luyou-2023/VCU-DEV-DOCS/VCU整套开发源码+PCB原理图+说明书/VCU用户资料/软件部分/基于J1939整车控制器CAN协议说明文档.pdf

整车控制器通讯协议 版本： | V0.1.0 | 2014/10/5
本协议参照SAEJ1939标准 | 整车网络通讯硬件要求
CAN总线结点地址如果J1939已有定义，则尽量使用J1939已定义的地址；1）各系统相互间的数据交换必须通过整车控制器才能实现；
具有多个功能的VCU，可以使用多个地址也可以重新定义新的地址； 2）网络系统支持热拔插，电源应具有反接保护和掉电检测功能；
新定义地址，应使用208～231这段属于公路用车的预留地址， | 3）控制器电源应符合GB/T11858.3标准的规定
报文编号为分配给每个结点的能进行目的寻址的报文编号空间。 | 4）CAN总线的通信电缆采用屏蔽双绞线（阻燃0.5mm），屏蔽层应连接到CAN_GND，屏蔽线的接地方式由整车布线时选择合适位置单点接地；
整车控制器 | SA=39 | SAEJ1939已定义 | 5）网络的接线拓扑为一个尽量紧凑的线形结构以避免电缆反射。
电机控制器 | SA=239 | SAEJ1939已定义 | VCU接入总线主干网的电缆要尽可能短。为使驻波最小化，节点不能在网络上等间距接入，接入线也不能等长，且接入线的最大长度应小于1m；
电池管理系统 SA=243 | SAEJ1939已定义 | 6）CAN总线上各部件均有终端电阻（120Ω ），同时，终端电阻同网络线之间通过跳线连接，以便灵活搭配，方便调试使用，装车时去掉；
DC/DC | SA=214 | 新定义 | 7）终端电阻头(120Ω )安装在网络线两端，做在线束中；
充电机 | SA=229 | 新定义 | 8）所有通信电缆应尽量离开动力线（0.5m以上）、离开12V控制线（0.1m以上）；
数字仪表 | SA=40 | SAEJ1939已定义 | 9）电缆屏蔽层在车内连续导通，建议每个部件的网络插座有屏蔽层的接头；
空调 | SA=231 | 新定义 | 10）CAN总线所有结点均有光耦隔离。

CAN 总 线 网
络报文结构图 | 发送节点 | 接收节点 | 波特率

### 以上为29标 识符的分配

表：

其中，优先级为3位，可以有8个优先级；R一般固定为0；DP现固定为0； | 字节 | 位 | 分辨率
8位的PF为报文的代码； | 0
8位的PS为目标地址或组扩展；8位的SA为发送此报文的源地址。 | 1

3
4 | ChargeConnect | 充电线连接 | 0：未连接1：已连接
5 | ChargeState | 电池组充电 | 0：未充电1：正在充电
6 | VechileMode | 整车模式 | 0：动力模式1：经济模式
7
1 | | AccPedalPos | 加速踏板位置 | 0~100%（0-1000） 偏移量：0 | 0.1%/bit

2

3 | | BrakePedalPos | 制动踏板位置 | 0~100%（0-1000） | 0.1%/bit
4
5 | 0 | VCUState | 整车控制器Ready | 0：ready 1：no ready
| 1 | BMSState | 电池管理单元在线 | 00：自检成功 01，10进行中
2
3 | DriveSysState | 驱动系统在线 | 0：正常1：故障
4 | AccPedalState | 加速踏板故障 | 0：正常1：故障
5 | BrakePedalState | 制动踏板故障 | 0：正常1：故障
6 | DCDCState | DCDC故障 | 0：正常1：故障
7 | ACState | 空调故障 | 0：正常1：故障
6 0.2V/bit | | LowBatVoltage | 低压电池电压 | 0-50V 偏移量：0
7
报文名称 | 发送节点 | 接收节点 | ID(hex) | 波特率
报文2 formVCU to Display | VCU | DISPLAY | 0X0C012827 | 250kb/s
P | R | DP | PF | PS | SA | 发送周期
3 | 0 | 0 | 1 | 40 | 39 | 100ms
字节 | 位 | 信号名称 | 物理含义 | 范围与含义 | 分辨率
0 | | MotorSpeed | 电机转速 | 0~16063.75rpm（0~64255） | 0.25rpm/bit
1
| 0 | MCUOverVol | MCU过压报警 | 0：正常1：报警
| 1 | MCULowVol | MCU欠压报警 | 0：正常1：报警
| 2 | MCUOverCurr | MCU过流报警 | 0：正常1：报警
| 3 | MCUOverTem 2 | MCU温度保护报警 | 0：正常1：报警
| 4 | MCUDriveFault | MCU驱动保护 | 0：正常1：报警
| 5 | MotorOverTemp | 电机过温 | 0：正常1：报警
| 6 | MotorState | 电机状态 | 0：正常1：报警
| 7
3 0.1℃/bit | | MCUTemp | 电机控制器温度 | -40~210℃偏移量40
4 0.1℃/bit | | MotorTemp | 电机温度 | -40~210℃ 偏移量40
5 | 0 | MCUWorkeState | MCU工作状态 | 1：工作 0：停止工作
| 1 | MotorWorkeMode | 电机工作模式 | 1：转矩模式0：转速模式
| 2 | MotorDirection | 电机运行方向 | 1：电机正转0：电机反转
| 3 | MotorLoad | 电机降功率运行 | 0：正常 1 ：降功率
| 4
| 5
| 6
| 7
6 1(km/h)/bit | | VehicleSpeed | 车速 | 0~200 偏移量0
7 | | | 电机控制器时序标号 | 0～255 循环
报文名称 | 发送节点 | 接收节点 | ID(hex) | 波特率
报文4 formVCU to Display | VCU | DISPLAY | 0X18032827 | 250kb/s
P | R | DP | PF | PS | SA | 发送周期
6 | 0 | 0 | 3 | 40 | 39 | 100ms
字节 | 位 | 信号名称 | 物理含义 | 范围与含义 | 分辨率
0 | | BatteryVoltage | 电池总电压 | 0~1000 偏移量：0 | 0.1V/bit
1
2 | | BatteryCurrent | 电池总电流 | -3200~3200偏移量3200 | 0.1A/bit
3
4 0.4%V/bit | | BatterySOC | 电池SOC | 0~100%
5 | 0 | ModuVolHigh 模块电压过高（停止充电） | | 0：正常1：报警
| 1 | ModuVolLow | 模块电压过低 | 0：正常1：报警
| 2 | SOCHigh | SOC过高（停止充电） | 0：正常1：报警
| 3 | SOCLow | SOC过低（需补电） | 0：正常1：报警
| 4 | CurrentHigh | 过电流 | 0：正常1：报警
| 5 | OverTemp | 温度过高停车 | 0：正常1：报警
| 6 | UnderSOC | SOC太低停车 | 0：正常1：报警
| 7 | NoMatch | 不匹配 | 0：正常1：报警
6 | 0 | BatBalancFault | 电池均衡故障 | 0：正常1：报警
| 1 | InsulatFault | 绝缘等级 | 00：无故障 01：1级故障 10：2级故障11：备用
2
3 | Connect1stFault | 第1箱连接故障 | 0：正常1：报警
4 | Connect2ndFault | 第2箱连接故障 | 0：正常1：报警
5 | Connect3rdFault | 第3箱连接故障 | 0：正常1：报警
6 | Connect4thFault | 第4箱连接故障 | 0：正常1：报警
7 | Connect5veFault | 第5箱连接故障 | 0：正常1：报警
7 | 0 | Connect6thFault | 第6箱连接故障 | 0：正常1：报警
| 1 | Connect7enFault | 第7箱连接故障 | 0：正常1：报警
| 2 | Connect8htFault | 第8箱连接故障 | 0：正常1：报警
| 3—7 | reserved | …
报文名称 | | | ID(hex)
报文1 formVCU to Display | VCU | DISPLAY | 0x0C002827 | 250kb/s
P | R | DP | PF | PS | SA | 发送周期
3 | 0 | 0 | 0 | 40 | 39 | 100ms
| | 信号名称 | 物理含义 | 范围与含义
0 | | GearPosition | 档位位置 | 00：空挡 01：倒档 10：前进 11：备份
| 2 | KEYSwitch | 点火钥匙位置信息 | 00：OFF 01：ACC 10：ON 11：STAR

报文名称 | 发送节点 | 接收节点 | ID(hex) | 波特率
报文4 formVCU to Display | VCU | DISPLAY | ID=0X18042827 | 250kb/s
P | R | DP | PF | PS | SA | 发送周期
6 | 0 | 0 | 4 | 40 | 39 | 100ms
字节 | 位 | 信号名称 | 物理含义 | 范围与含义 | 分辨率
0 | | BatteryMinVol | 电池模块最低电压 | 0~15 偏移量：0 | 0.01V/bit
1
2 | | BatteryMaxVol | 电池模块最高电压 | 偏移量：0 | 0.01A/bit 0~15
3
4 0.1℃/bit | | BatteryMaxTemp | 电池模块最高温度 | -40~210℃ 偏移量40
5 0.1℃/bit | | BatteryTempDiff | 电池模块最低温度 | -40~210℃ 偏移量40
6 2Ah/bit | | RestSoc | 剩余容量 | 0~510Ah偏移量：0
7 | | BatteryLife | 电池管理系统时序标号 | 0～255 循环
报文名称 | 发送节点 | 接收节点 | ID(hex) | 波特率
| DISPLAY | VCU | ID=0X18472728 | 250kb/s
P | R | DP | PF | PS | SA | 发送周期
6 | 0 | 0 | 71 | 39 | 40 | 100ms
字节 | 位 | 信号名称 | 物理含义 | 范围与含义 | 分辨率
0 | 0
| 1
| 2
| 3 | BrakePedalIO | 刹车开关 | 0：关1：开
| 4 | HandBrakeSwitch | 仪表单元工作状态 | 0：不正常1：正常
| 5 | DisplayState | 手刹制动开关 | 0：关1：开
| 6
| 7
1 | | TotalMileage | 里程 | 0~30万公里，偏移量：0 | 0.1(km/h)/bit
2
3
4
5 0.2V/bit, | | LowBatteryVol | 低压电池电压 | 0-50,偏移量：0
6 | | LIFE | 时序标号 | 0～255 循环
7
报文名称 | 发送节点 | 接收节点 | ID(hex) | 波特率
报文1 formVCUtoAC | VCU | AC | 0X183BE727 | 250kb/s
P | R | DP | PF | PS | SA | 发送周期
6 | 0 | 0 | 59 | 231 | 39 | 200ms
字节 | 位 | 信号名称 | 物理含义 | 范围与含义 | 分辨率
0 0.4%V/bit | | BatterySOC | 电池SOC | 0~100%
1 1℃/bit | | SetLowTemp | 制冷空调最低温度设定 | -40~210℃ 偏移量40
2 1℃/bit | | SetHighTemp | 制冷空调最高温度设定 | -40~210℃ 偏移量40
3 | | LIFE | 时序标号 | 0～255 循环
4
5
6
7
报文名称 | 发送节点 | 接收节点 | ID(hex) | 波特率
报文1 formACtoVCU | AC | VCU | 0X184C27E7 | 250kb/s
P | R | DP | PF | PS | SA | 发送周期
6 | 0 | 0 | 76 | 39 | 231 | 200ms
字节 | 位 | 信号名称 | 物理含义 | 范围与含义 | 分辨率
0 1℃/bit | | InterTemp | 室内温度 | -40~210℃ 偏移量40
1 0.4%V/bit | | ACLoad | 空调负荷 | 0~100%
| 0 | PressFault | 压力异常 | 00：正常01：过高 10：过低11：备份
1
2 | VoltagFault | 过欠压报警 | 0：正常1：过欠压
3 | OverCurrent | 过流 | 0：正常1：过流 2
4
5
6
7
3
4 | | LIFE | 时序标号 | 0～255 循环
5
6
7

报文1
formDisplay toVCU

报文名称 | 发送节点 | 接收节点 | ID(hex) | 波特率
报文1 formVCUtoCDDC | VCU | DCDC | ID=0X183BD627 | 250kb/s
P | R | DP | PF | PS | SA | 发送周期
6 | 0 | 0 | 59 | 214 | 39 | 200ms
字节 | 位 | 信号名称 | 物理含义 | 范围与含义 | 分辨率
0 | | DCDCNum | DCDC编号 | 0~1111
1 | 0
| 1
| 2
| 3
| 4
| 5 | DCDCCurDir | 控制DC/DC电流方向 | 0：正向1：反向
| 6 | DCDCSwitch | 控制DC/DC开关 | 0：未接通1：已接通
| 7
2
3
4 1A/bit | | DCDCRefCur | DC/DC目标电流 | .-32000~32255偏移量：-
5 1V/bit | | DCDCRefVol | DC/DC目标电压 | 0~64255偏移量：1
6 | | LIFE | 时序标号 | 0～255 循环
7
报文名称 | 发送节点 | 接收节点 | ID(hex) | 波特率
报文2 formVCUtoMCU | VCU | MCU | ID=0x0C40EF27 | 500kb/s
P | R | DP | PF | PS | SA | 发送周期
3 | 0 | 0 | 64 | 239 | 39 | 10ms
字节 | 位 | 信号名称 | 物理含义 | 范围与含义 | 分辨率
0 | | MotorRefSpeed | 电机目标转速 | 0~15000,(0~15000) | 0.1RPM/位
1
2 | | MotorRefTorque | 电机目标转矩 | 0.1Nm/位, -1000~1000,(0~20000) | 0.1Nm/位
3
4 | 0 | MCUWorkeState | MCU工作状态 | 1：工作 0：停止工作
| 1 | MotorWorkeMode | 电机工作模式 | 1：转矩模式0：转速模式
| 2 | MotorDirection | 电机运行方向 | 1：电机正转0：电机反转
| 3 | MotorLoad | 电机降功率运行 | 0：正常 1 ：降功率
| 4
| 5
| 6
| 7
5 | | LIFE | 整车控制器时序标号 | 0～255 循环
6 | | MaxSpeed | 电机最大转速 电机目标转速,,0~15000,(0~15000) | | 0.1RPM/位
7
报文名称 | 发送节点 | 接收节点 | ID(hex) | 波特率
报文1 formVCUtoMCU | VCU | MCU | ID=0x1811EF27 | 500kb/s
P | R | DP | PF | PS | SA | 发送周期
6 | 0 | 0 | 17 | 239 | 39 | 10ms
字节 | 位 | 信号名称 | 物理含义 | 范围与含义 | 分辨率
0 | | AccPedal | 加速踏板开度 | 0~100%（0-1000） 偏移量：0 | 0.1%/bit
1
2 | | BrakePedal | 制动踏板开度 | 0~100%（0-1000） | 0.1%/bit
3
4 | 0 | KEYSwitch | 点火钥匙位置信息 | 00：OFF 01：ACC 10：ON 11：STAR
1
2
3
4 | MCUStart | MC允许启动 | 0：不允许 1：允许
5 | MCUDischarge | 电容放电指令 | 00：不允许 01：允许
6
7
5
6
7
报文名称 | 发送节点 | 接收节点 | ID(hex) | 波特率
报文1 formMCUtoVCU | MCU | VCU | ID=0x0C2027EF | 500kb/s
P | R | DP | PF | PS | SA | 发送周期
3 | 0 | 0 | 32 | 39 | 239 | 10ms
字节 | 位 | 信号名称 | 物理含义 | 范围与含义 | 分辨率
0 | 0 | RelayStatus | 接触器状态 | 1：闭合 0：断开
| 1 | MotorEleGen | 电机工作模式 | 1：发电 0：电动
| 2 | MotorWorkState1 | 电机运行状态1 | 1：空转 0：其他
| 3 | MotorWorkState2 | 电机运行状态2 | 1：转矩模式0：转速模式
| 4 | MotorWorkState3 | 电机运行状态3 | 1：反转0：正转 1：冷却风开0：冷却风关
| 5 | FanState | 冷却风机状态
| 6
| 7 | MCUFault | 电动机控制器故障状 | 1：故障 0：正常
1 | | LIFE | LIFE | 0~255
2 | | MotorSpeed | 电动机转速 | 0~15000,t, 偏移量：0 | 0.1RPM/bi
3
4 | | MotorTorque | 电机扭矩 | ,-1000~1000,(0~20000) 偏移 量10000 | 0.01Nm/位
5
6 | | MotorCurrent | 电动机相电流 | 0~20000,偏移量：10000 | 0..1A/bit
7

GearPosition

档位 | 00：N 01：D 10：R 11：备用

报文名称 | 发送节点 | 接收节点 | ID(hex) | 波特率
报文2 formMCUtoVCU | MCU | VCU | ID=0x0C2127EF | 500kb/s
P | R | DP | PF | PS | SA | 发送周期
3 | 0 | 0 | 33 | 39 | 239 | 10ms
字节 | 位 | 信号名称 | 物理含义 | 范围与含义 | 分辨率
0 | | MCUTemp | 控制器温度 | .-40~210 偏移量：-40 | 0.1oC/bit
1
2 | | MotorTemp | 电动机温度 | .-40~210 偏移量：-40 | 0.1oC/bit
3
4 | | BatteryVoltage | 电池电压 | 0~10000，偏移量：0 | 0.1V/bit
5
6 | 0 | DCVoltaOver | 直流侧过压 | 1：过压0：正常
| 1 | IGBTFault | IGBT故障 | 1：故障0：正常
| 2 | OverCurrent | 过流 | 1：过流 0：正常
| 3 | BatteryOverVol | 电池过压 | 1：欠压 0：正常
| 4 | BatteryUnderVol | 电池过压 | 1：过压 0：正常
| 5 | MCUHot | 控制器过热 | 1：过热 0：正常
| 6 | MotorHot | 电池欠压 | 1：欠压 0：正常
| 7 | SpeedLimit | 超速 | 1：超速 0：正常
7 1(km/h)/bit | | VehicleSpeed | 车速 | 0~200 偏移量0
报文名称 | 发送节点 | 接收节点 | ID(hex) | 波特率
报文3 formMCUtoVCU | MCU | VCU | ID=0x0C2227EF | 500kb/s
P | R | DP | PF | PS | SA | 发送周期
3 | 0 | 0 | 34 | 39 | 239 | 10ms
字节 | 位 | 信号名称 | 物理含义 | 范围与含义 | 分辨率
0 | | MotorMaxDrivPow | 电机最大驱动功率 | 0~10000 偏移量：0 | 0.1kW/位
1
2 | | MotorMaxBrakPow | 电机最大制动功率 | 0~10000(0~1000) | 0.1kW/位
3
4 | | MotorMaxElecTrq | 电机最大电动转矩 | 0~10000(0~1000) | 0.1Nm/位
5
6 | | MotorMaxBrakTrq | 电机最大制动转 | 0~10000(0~1000) | 0.1Nm/位
7
报文名称 | 发送节点 | 接收节点 | ID(hex) | 波特率
报文1 formVCUtoBMS | VCU | BMS | ID=0x18FFF327 | 500kb/s
P | R | DP | PF | PS | SA | 发送周期
6 | 0 | 0 | 5534 | 243 | 39 | 10ms
字节 | 位 | 信号名称 | 物理含义 | 范围与含义 | 分辨率
0 1/bit | | LIFE | | 0~255，
1 | | AllowCharge | 充电运许 | 1 :允许 0：不允许
2
3 1(km/h) | | VehicleSpeed | 车速 | 0~200
4 | | TotalMileage | 里程 | 0~30万公里 偏移量：0 | 0.1(km/h)/bit
5
6
7
报文名称 | 发送节点 | 接收节点 | ID(hex) | 波特率
报文1 formBMStoVCU | BMS | VCU | ID=0x183027F3 | 500kb/s
P | R | DP | PF | PS | SA | 发送周期
6 | 0 | 0 | 48 | 39 | 243 | 10ms
字节 | 位 | 信号名称 | 物理含义 | 范围与含义 | 分辨率
0 | | BatteryVoltage | 电池总电压 | 0~1000，,偏移量：0 | 0.1V/bit
1
2 | | BatteryCurrent | 电池总电流 | .-3200~3353.5 偏移量：32000 | 0.1A/bit
3
4 0.4%V/bit | | BatterySOC | | 0~100，偏移量：0
5 1/bit | | LIFE | | 0~255，偏移量：0
6
7
报文名称 | 发送节点 | 接收节点 | ID(hex) | 波特率
报文2 formBMStoVCU | BMS | VCU | ID=0x183127F3 | 500kb/s
P | R | DP | PF | PS | SA | 发送周期
6 | 0 | 0 | 49 | 39 | 243 | 10ms
字节 | 位 | 信号名称 | 物理含义 | 范围与含义 | 分辨率
0 | 0 | BMSCheck | 电池管理系统自检状态 00：- 01：自检进行中 | 10自检成功 11自检失败
1
2 | ChargeConnect | 充电器连接 | 1：连接, 0：断开
3 | ChargeState | 充电状态 | 正在充电:1 充电完成：0
4
5
6
7
1 | 0 | ModuVolHigh | 模块电压高 | 1 :报警;0:未报警
| 1 | ModuVolLow | 模块电压低 | 1 :报警;0:未报警
| 2 | SOCHigh | SOC过高 | 1 :报警;0:未报警
| 3 | SOCLow | SOC过低需补电 | 1 :报警;0:未报警
| 4 | CurrentHigh | 过电流 | 1 :报警;0:未报警
| 5 | OverTemp | 温度过高 | 1 :报警;0:未报警
| 6 | UnderSOC | SOC太低 | 1 :报警;0:未报警
| 7 | NoMatch | 不匹配 | 1 :报警;0:未报警
2 | 0 | BatBalancFault | 电池均衡故障 | 0：正常,1：故障
| 1 | | 绝缘等级 InsulatFault | 00：无故障 01：1级故障 10：2级故障 11：备用
2
3 | Connect1stFault | 第1箱连接故障 | 0：正常,1：故障
4 | Connect2ndFault | 第2箱连接故障 | 0：正常,1：故障
5 | Connect3rdFault | 第3箱连接故障 | 0：正常,1：故障
6 | Connect4thFault | 第4箱连接故障 | 0：正常,1：故障
7 | Connect5veFault | 第5箱连接故障 | 0：正常,1：故障
3 | 0 | Connect6thFault | 第6箱连接故障 | 0：正常,1：故障
| 1 | Connect7enFault | 第7箱连接故障 | 0：正常,1：故障
| 2 | Connect8thFault | 第8箱连接故障 | 0：正常,1：故障
| 3
| 4
| 5
| 6
| 7
4 | | FaultNum | 故障数 | 0-256
5
6
7

报文名称 | 发送节点 | 接收节点 | ID(hex) | 波特率
报文3 formBMStoVCU | BMS | VCU | ID=0x183227F3 | 500kb/s
P | R | DP | PF | PS | SA | 发送周期
6 | 0 | 0 | 50 | 39 | 243 | 10ms
字节 | 位 | 信号名称 | 物理含义 | 范围与含义 | 分辨率
0 | 0 | VolHigh | 总电压高 | 1：故障,0：正常
| 1 | VolLow | 总电压低 | 1：故障,0：正常
| 2 | SingleVolHigh | 单体电压高 | 1：故障,0：正常
| 3 | SingleVolLow | 单体电压低, | 1：故障,0：正常
| 4 | SingleTempHigh | 单体温度高 | 1：故障,0：正常
| 5 | SingleTempLow | 单体温度低 | 1：故障,0：正常
| 6 | TempDiff | 温差大 | 1：故障,0：正常
| 7 | PressDiff | 压差大 | 1：故障,0：正常
1 | 0 | SOCLow | SOC低 | 1：故障,0：正常
| 1 | SOCHigh | SOC高 | 1：故障,0：正常
| 2
| 3
| 4
| 5
| 6
| 7
2 | 0 | PressDiffHigh | 压差过大 | 1：故障,0：正常
| 1 | TempDiffHigh | 温差过大 | 1：故障,0：正常
| 2 | STempServeLow | 单体温度过低 | 1：故障,0：正常
| 3 | STempServeHigh | 单体温度过高 | 1：故障,0：正常
| 4 | SVolServeLow | 单体电压过低 | 1：故障,0：正常
| 5 | SVolServeHigh | 单体电压过高 | 1：故障,0：正常
| 6 | VolServeLow | 总电压过低 | 1：故障,0：正常
| 7 | VolServeHigh | 总电压过高 | 1：故障,0：正常
3 | 0
| 1 | LowTempCharge | 低温充电告警 | 1：禁止充电,0：允许充电
| 2 | BMSFault | BMS系统故障 | 1：故障, 0：正常
| 3 | InsulatFult | 绝缘故障 | 1：故障, 0：正常
| 4 | DischargeCurrHi | 放电电流过大 | 1：故障, 0：正常
| 5 | ChargCurrHi | 充电电流过大 | 1：故障, 0：正常
| 6 | SOCServeHigh | SOC过高 | 1：故障, 0：正常
| 7 | SOCServeLow | SOC过低 | 1：故障, 0：正常
4
5
6
7 | | FaultNum | 故障数
报文名称 | 发送节点 | 接收节点 | ID(hex) | 波特率
报文4 formBMStoVCU | BMS | VCU | ID=0x183327F3 | 500kb/s
P | R | DP | PF | PS | SA | 发送周期
6 | 0 | 0 | 51 | 39 | 243 | 10ms
字节 | 位 | 信号名称 | 物理含义 | 范围与含义 | 分辨率
0 | | MaxChargeCur | 最大允许充电电流 | 0~10000，偏移量：0 | 0.1A/bit
1
2 | | MaxDisChargeCur | 最大允许放电电流 | 0~10000，偏移量：0 | 0.1A/bit
3
4 | | DischrgeVolCutOff | 放电截止电压 | 0~10000 偏移量：0 | 0.1V/bit
5
6
7
报文名称 | 发送节点 | 接收节点 | ID(hex) | 波特率
报文5 formBMStoVCU | BMS | VCU | ID=0x183427F3 | 500kb/s
P | R | DP | PF | PS | SA | 发送周期
6 | 0 | 0 | 52 | 39 | 243 | 10ms
字节 | 位 | 信号名称 | 物理含义 | 范围与含义 | 分辨率
0 | | BattAllowMaxTemp | 电池组最高允许温度。-40~210，偏移量：-40 | | 1oC/bit
1 0.4A/bit | | BattAllowLowSOC电池组允许放电最低SOC | | 0~250，偏移量：1
2 | | BatteryMinVol | 电池模块最低电压 | 0~15，偏移量：0 | 0.01V/bit
3
4 | | BatteryMaxVol | 电池模块最高电压 | 0~15，偏移量：0 | 0.01V/bit
5
6 1oC/bit | | BatteryMaxTemp | 电池模块最高温度 | 。-40~210偏移量：40
7 | | BatteryTempDiff | 电池模块温度极差 | 。-40~210偏移量：40 | 1oC/bit
