luyou-2023/VCU-DEV-DOCS/VCU整套开发源码+PCB原理图+说明书/VCU用户资料/软件部分/赠送资料/USBCAN接口卡/API/API Samples/vc6/test/说明.txt

exe程序 必须和 ControlCAN.dll 以及 kerneldlls 文件夹在一起
