luyou-2023/VCU-DEV-DOCS/VCU整套开发源码+PCB原理图+说明书/原理和PCB图/VCU原理图.pdf

# 晶电电电

# CAN通模

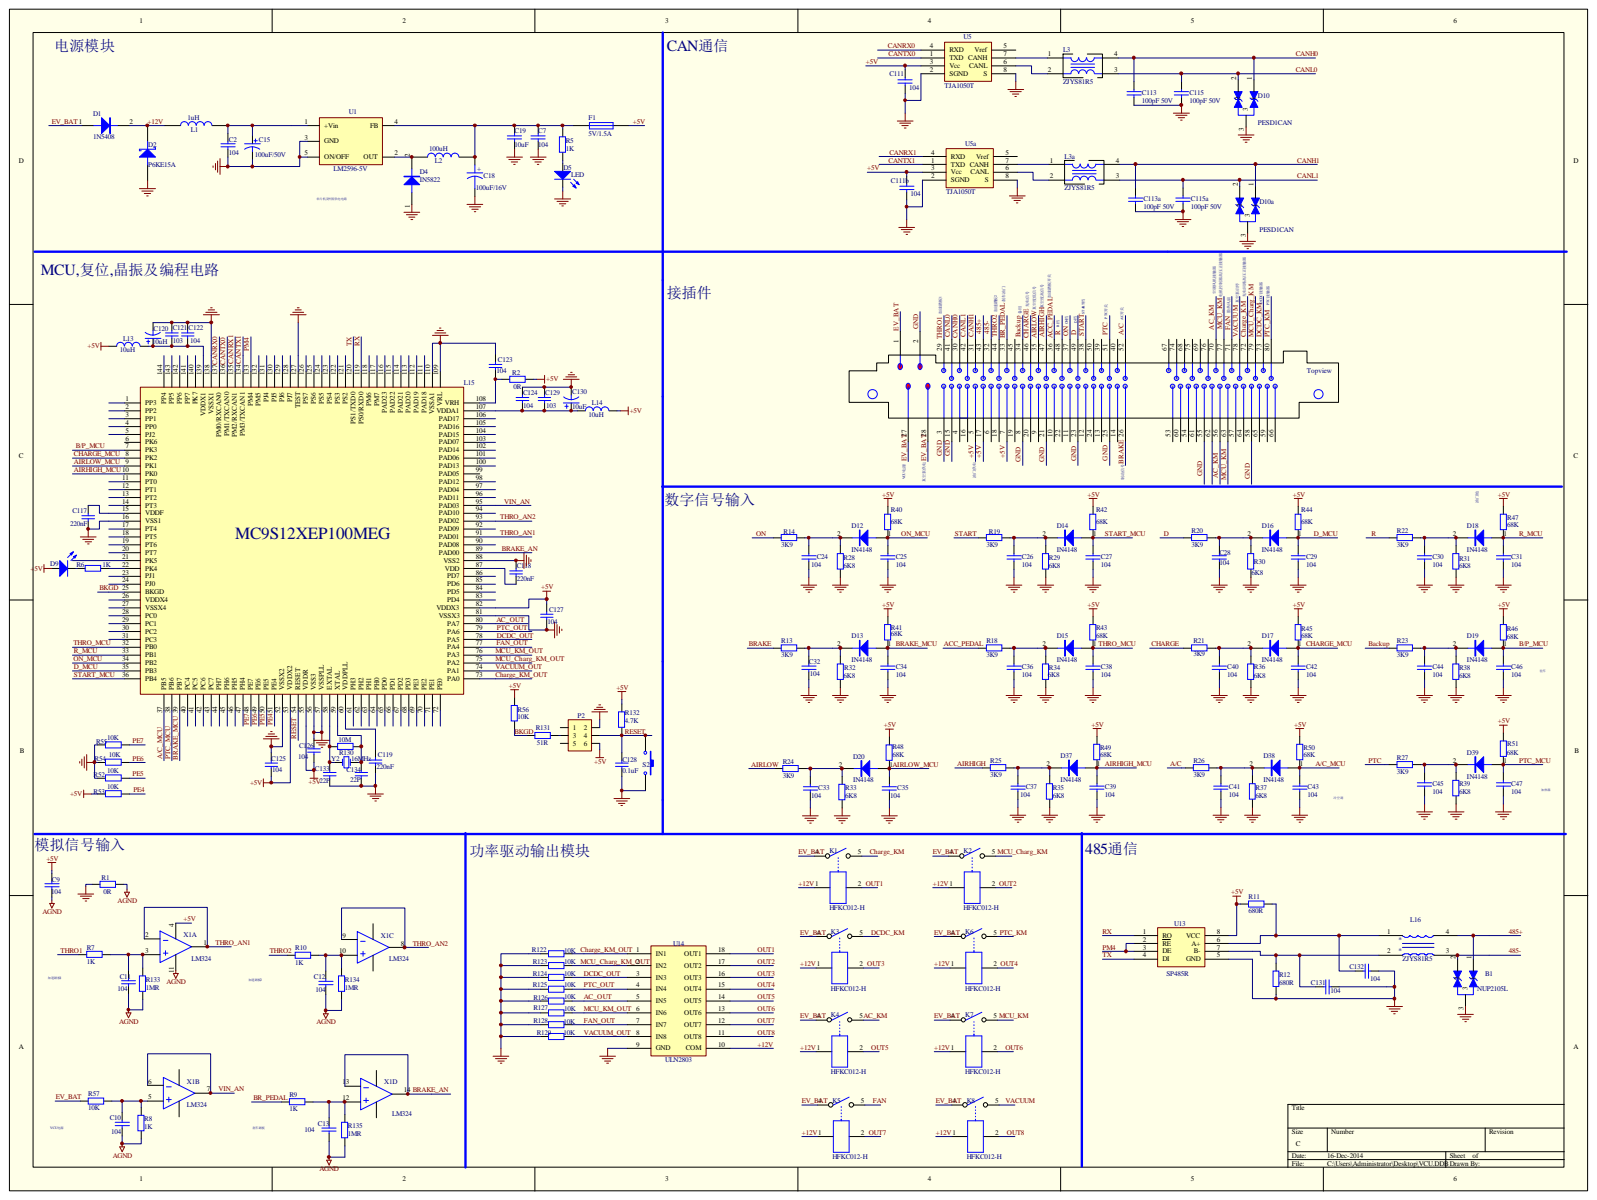
[picture p29: page 1]
