luyou-2023/VCU-DEV-DOCS/VCU整套开发源码+PCB原理图+说明书/VCU用户资料/软件部分/上位机使用说明文档.pdf

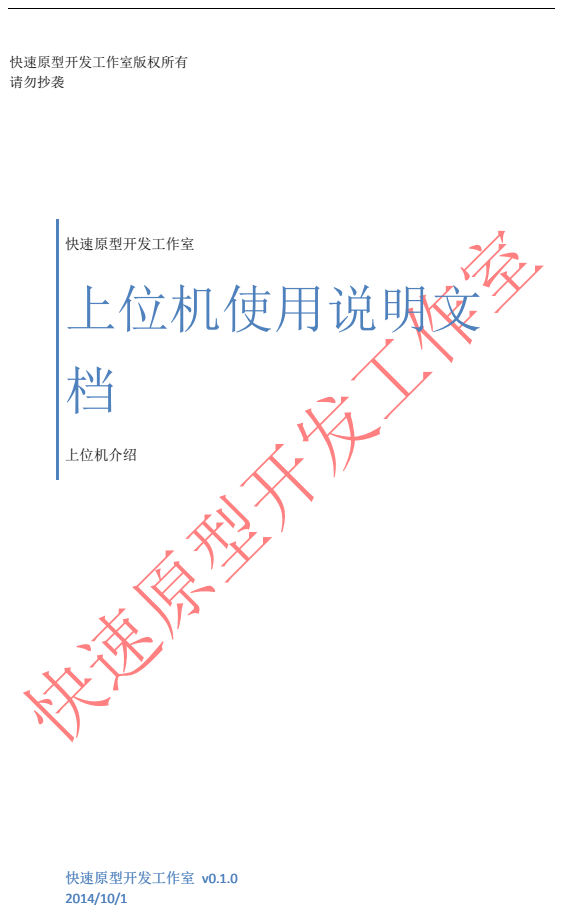
[picture p54: page 1]
快速原型开发工作室版权所有 请勿抄袭; 快速原型开发工作室 上位机使用说明文; 上位机介绍; 快速原型开发工作室 v0.1.0

# 1、上位机使用说明

## 上位机使用 485 总线实现参数的标定和数据的实时监控。上位机使用 labview

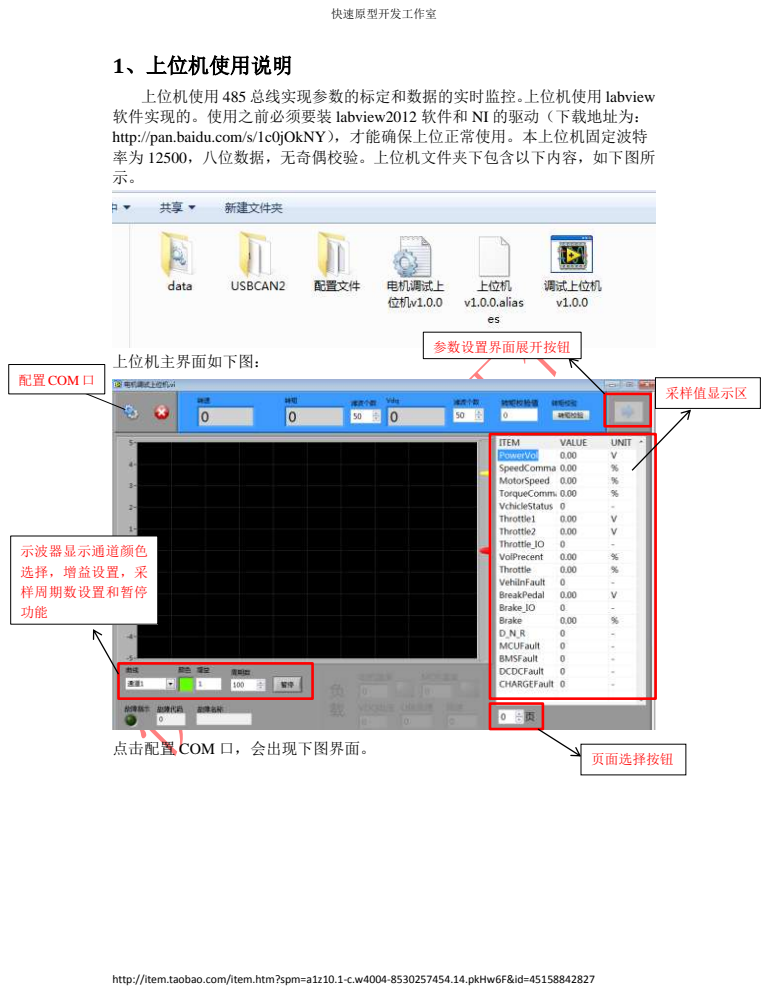
[picture p55: page 2]
快速原型开发工作室; 上位机主界面如下图：; 配置COM口; 采样值显示区; 页面选择按钮; 参数设置界面展开按钮; 示波器显示通道颜色 选择，增益设置，采 样周期数设置和暂停 功能

软件实现的。使用之前必须要装 labview2012 软件和 NI 的驱动（下载地址为：
http://pan.baidu.com/s/1c0jOkNY），才能确保上位正常使用。本上位机固定波特
率为 12500，八位数据，无奇偶校验。上位机文件夹下包含以下内容，如下图所

点击配置 COM 口，会出现下图界面。

http://item.taobao.com/item.htm?spm=a1z10.1-c.w4004-8530257454.14.pkHw6F&id=45158842827

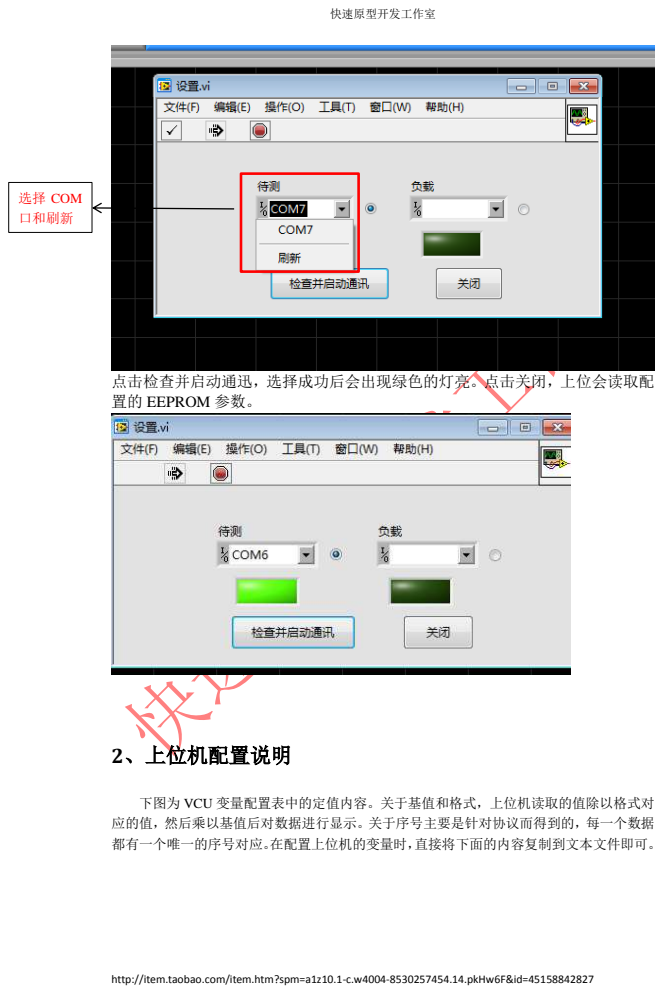
[picture p56: page 3]
2、上位机配置说明; 选择 COM 口和刷新

点击检查并启动通迅，选择成功后会出现绿色的灯亮。点击关闭，上位会读取配
置的 EEPROM 参数。

下图为 VCU 变量配置表中的定值内容。关于基值和格式，上位机读取的值除以格式对
应的值，然后乘以基值后对数据进行显示。关于序号主要是针对协议而得到的，每一个数据
都有一个唯一的序号对应。在配置上位机的变量时，直接将下面的内容复制到文本文件即可。

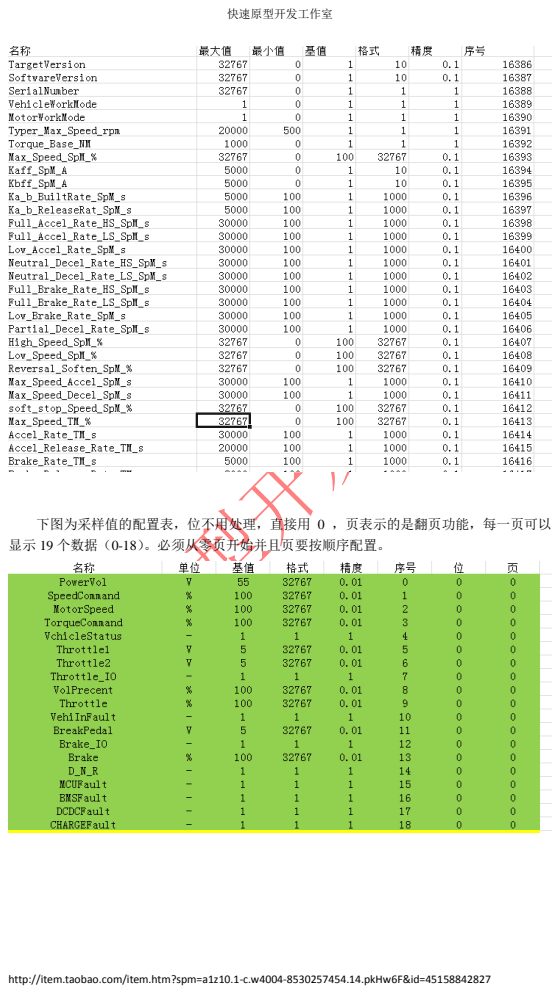
[picture p57: page 4]

下图为采样值的配置表，位不用处理，直接用 0 ，页表示的是翻页功能，每一页可以
显示 19 个数据（0-18）。必须从零页开始并且页要按顺序配置。

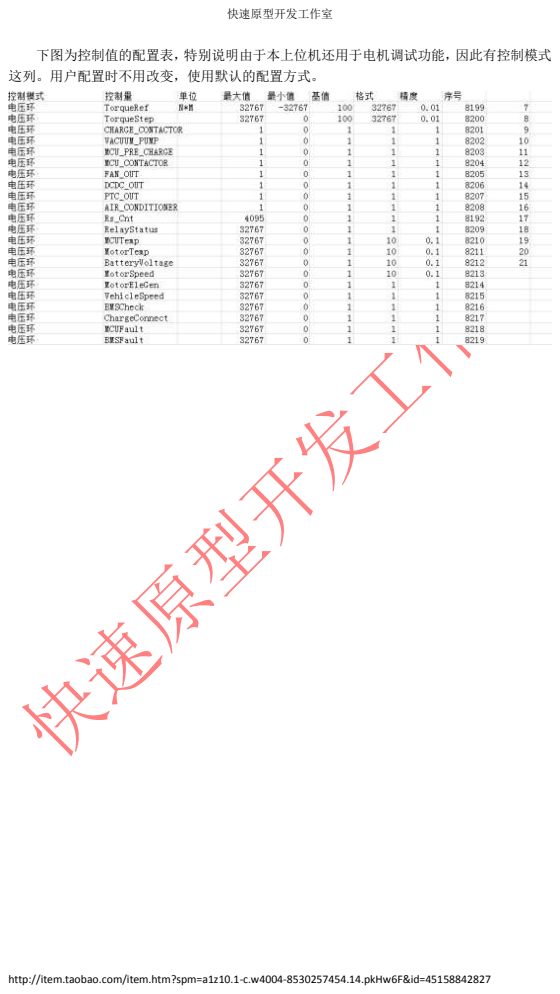
[picture p58: page 5]

下图为控制值的配置表，特别说明由于本上位机还用于电机调试功能，因此有控制模式
这列。用户配置时不用改变，使用默认的配置方式。
