luyou-2023/VCU-DEV-DOCS/(list of files, drawings)

Other design files:
VCU整套开发源码+PCB原理图+说明书/原理和PCB图/0to5V输出模块.SchDoc
VCU整套开发源码+PCB原理图+说明书/原理和PCB图/3V3低压模块.SchDoc
VCU整套开发源码+PCB原理图+说明书/原理和PCB图/MCU模块.SchDoc
VCU整套开发源码+PCB原理图+说明书/原理和PCB图/PI_DI_Input.SchDoc
VCU整套开发源码+PCB原理图+说明书/原理和PCB图/PWM输出.SchDoc
VCU整套开发源码+PCB原理图+说明书/原理和PCB图/VCU_1_2.SchDoc
VCU整套开发源码+PCB原理图+说明书/原理和PCB图/wangxh/0to5V输出模块.SchDoc
VCU整套开发源码+PCB原理图+说明书/原理和PCB图/wangxh/3V3低压模块.SchDoc
VCU整套开发源码+PCB原理图+说明书/原理和PCB图/wangxh/MCU模块.SchDoc
VCU整套开发源码+PCB原理图+说明书/原理和PCB图/wangxh/PI_DI_Input.SchDoc
VCU整套开发源码+PCB原理图+说明书/原理和PCB图/wangxh/PWM输出.SchDoc
VCU整套开发源码+PCB原理图+说明书/原理和PCB图/wangxh/低边开关模块.SchDoc
VCU整套开发源码+PCB原理图+说明书/原理和PCB图/wangxh/模拟信号输入1.SchDoc
VCU整套开发源码+PCB原理图+说明书/原理和PCB图/wangxh/电源模块.SchDoc
VCU整套开发源码+PCB原理图+说明书/原理和PCB图/wangxh/通信模块.SchDoc
VCU整套开发源码+PCB原理图+说明书/原理和PCB图/低边开关模块.SchDoc
VCU整套开发源码+PCB原理图+说明书/原理和PCB图/模拟信号输入1.SchDoc
VCU整套开发源码+PCB原理图+说明书/原理和PCB图/电源模块.SchDoc
VCU整套开发源码+PCB原理图+说明书/原理和PCB图/继电器功率驱动输出.SchDoc
VCU整套开发源码+PCB原理图+说明书/原理和PCB图/通信模块.SchDoc
VCU整套开发源码+PCB原理图+说明书/原理和PCB图/高边开关模块.SchDoc
