luyou-2023/VCU-DEV-DOCS/VCU整套开发源码+PCB原理图+说明书/VCU用户资料/软件部分/赠送资料/串口调试工具/AccessPort/AccessPort.ini

[Setting]
Language=Chinese(Simplified)
[AccessPort]
SerialPort=1
BaudRate=9600
ParityBit=N
DataBit=8
StopBit=0
FlowControl=0
BufferSize=8192
SendCycle=400
BytesPerLine=16
CopyHexDumpMode=0
SelectCharMode=0
MaxLogSize_MB=6
TextColor=0
BgColor=16777215
SysParameter=18360949
SendFile=
PredefDataFile=
AutoAckDataFile=
Font_Desc=-11:0:0:0:400:0:0:0:0:1:2:0:34
Font_Name=Lucida Sans Unicode
