luyou-2023/VCU-DEV-DOCS/VCU整套开发源码+PCB原理图+说明书/VCU用户资料/软件部分/VCU_v0.1.0/Sources/crc16.c

/*====================================================================================
* File name: 	 CRC.c
* Description:  .  
* Created on:  01-12-2014
* Author:  JT
=======================================================================================
 History:
---------------------------------------------------------------------------------------
01-12-2014		Version 1.0.0       JT		Initialized version
-------------------------------------------------------------------------------------*/

#include <hidef.h>
#include "derivative.h"
#include "crc16.h"

// --------------------------------------------------------------
//      				CRC16 high and low table
// --------------------------------------------------------------
const unsigned char chCRCHTalbe[] = {
	0x00, 0xC1, 0x81, 0x40, 0x01, 0xC0, 0x80, 0x41, 0x01, 0xC0, 0x80, 0x41,
	0x00, 0xC1, 0x81, 0x40, 0x01, 0xC0, 0x80, 0x41, 0x00, 0xC1, 0x81, 0x40,
	0x00, 0xC1, 0x81, 0x40, 0x01, 0xC0, 0x80, 0x41, 0x01, 0xC0, 0x80, 0x41,
	0x00, 0xC1, 0x81, 0x40, 0x00, 0xC1, 0x81, 0x40, 0x01, 0xC0, 0x80, 0x41,
	0x00, 0xC1, 0x81, 0x40, 0x01, 0xC0, 0x80, 0x41, 0x01, 0xC0, 0x80, 0x41,
	0x00, 0xC1, 0x81, 0x40, 0x01, 0xC0, 0x80, 0x41, 0x00, 0xC1, 0x81, 0x40,
	0x00, 0xC1, 0x81, 0x40, 0x01, 0xC0, 0x80, 0x41, 0x00, 0xC1, 0x81, 0x40,
	0x01, 0xC0, 0x80, 0x41, 0x01, 0xC0, 0x80, 0x41, 0x00, 0xC1, 0x81, 0x40,
	0x00, 0xC1, 0x81, 0x40, 0x01, 0xC0, 0x80, 0x41, 0x01, 0xC0, 0x80, 0x41,
	0x00, 0xC1, 0x81, 0x40, 0x01, 0xC0, 0x80, 0x41, 0x00, 0xC1, 0x81, 0x40,
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
		MsgLo = (*pMsg) & 0xFF;
		pMsg++;

		wIndex = chCRCLo ^ MsgHi ;
		chCRCLo = chCRCHi ^ chCRCHTalbe[wIndex];
		chCRCHi = chCRCLTalbe[wIndex] ;

		wIndex = chCRCLo ^ MsgLo ;
		chCRCLo = chCRCHi ^ chCRCHTalbe[wIndex]; 
		chCRCHi = chCRCLTalbe[wIndex] ;
	} 

	return ((chCRCHi << 8) | chCRCLo);
}

/****************************************************************************************
describe: calculate 16bits LRC code
functionName: GetLRC16 
parameter: pchMsg	data point for calculating the LRC, preservation data first address.
           wDataLen	bytes for calculating the LRC
return value: LRC code
****************************************************************************************/
word GetLRC16(word* pMsg, word wDataLen)
{
	word LRC = 0;

	while (wDataLen--)
	{  // 计算LRC
		LRC = LRC + (((*pMsg)>>8) & 0x00ff) + ((*pMsg) & 0x00ff);
		pMsg++;
	}
	
	return ((0 - LRC) & 0x00ff);
}
