luyou-2023/VCU-DEV-DOCS/VCU整套开发源码+PCB原理图+说明书/VCU用户资料/软件部分/VCU_v0.1.0/include/crc16.h

/*====================================================================================
* File name: 	 CRC.h
* Description:  
* Created on:  01-12-2014
* Author:  JT
=======================================================================================
 History:
---------------------------------------------------------------------------------------
01-12-2014		Version 1.0.0       JT		Initialized version
-------------------------------------------------------------------------------------*/ 
#ifndef _CRC16_H
#define _CRC16_H

//get CRC16

word GetCRC16(word* pMsg, word wDataLen);

//get LRC16
word GetLRC16(word* pMsg, word wDataLen);

#endif

//===========================================================================
// No more.
//===========================================================================
