luyou-2023/VCU-DEV-DOCS/VCU整套开发源码+PCB原理图+说明书/VCU用户资料/软件部分/赠送资料/USBCAN接口卡/API/API Samples/vc6/test/testDlg.cpp

// testDlg.cpp : implementation file
//

#include "stdafx.h"
#include "test.h"
#include "testDlg.h"
#include "ControlCAN.h"
#pragma comment(lib,"controlcan.lib")

#ifdef _DEBUG
#define new DEBUG_NEW
#undef THIS_FILE
static char THIS_FILE[] = __FILE__;
#endif

//显示计数定时器
#define ID_TIMER_SHOWCNT 1
#define ID_TIMER_SHOWCNT_TM 1000 //1秒定时


/////////////////////////////////////////////////////////////////////////////
// CAboutDlg dialog used for App About

class CAboutDlg : public CDialog
{
public:
	CAboutDlg();

// Dialog Data
	//{{AFX_DATA(CAboutDlg)
	enum { IDD = IDD_ABOUTBOX };
	//}}AFX_DATA

	// ClassWizard generated virtual function overrides
	//{{AFX_VIRTUAL(CAboutDlg)
	protected:
	virtual void DoDataExchange(CDataExchange* pDX);    // DDX/DDV support
	//}}AFX_VIRTUAL

// Implementation
protected:
	//{{AFX_MSG(CAboutDlg)
	//}}AFX_MSG
	DECLARE_MESSAGE_MAP()
};

CAboutDlg::CAboutDlg() : CDialog(CAboutDlg::IDD)
{
	//{{AFX_DATA_INIT(CAboutDlg)
	//}}AFX_DATA_INIT
}

void CAboutDlg::DoDataExchange(CDataExchange* pDX)
{
	CDialog::DoDataExchange(pDX);
	//{{AFX_DATA_MAP(CAboutDlg)
	//}}AFX_DATA_MAP
}

BEGIN_MESSAGE_MAP(CAboutDlg, CDialog)
	//{{AFX_MSG_MAP(CAboutDlg)
		// No message handlers
	//}}AFX_MSG_MAP
END_MESSAGE_MAP()

/////////////////////////////////////////////////////////////////////////////
// CTestDlg dialog

CTestDlg::CTestDlg(CWnd* pParent /*=NULL*/)
	: CDialog(CTestDlg::IDD, pParent)
{
	//{{AFX_DATA_INIT(CTestDlg)
	m_EditSendData = _T("");
	m_EditSendFrmID = _T("");
	m_EditCode = _T("");
	m_EditMask = _T("");
	m_EditTiming0 = _T("");
	m_EditTiming1 = _T("");
	//}}AFX_DATA_INIT
	// Note that LoadIcon does not require a subsequent DestroyIcon in Win32
	m_hIcon = AfxGetApp()->LoadIcon(IDR_MAINFRAME);
	m_connect=0;
	m_cannum=0;

	m_devtype=VCI_PCI5121;

	m_btest=FALSE;

	//////////////////////////////////////////////////////////////////////////
	m_mapDevtype["VCI_PCI5121"]=VCI_PCI5121;
	m_mapDevtype["VCI_PCI9810"]=VCI_PCI9810;
	m_mapDevtype["VCI_USBCAN1(I+)"]=VCI_USBCAN1;
	m_mapDevtype["VCI_USBCAN2(II+)"]=VCI_USBCAN2;
	m_mapDevtype["VCI_USBCAN2A"]=VCI_USBCAN2A;
	m_mapDevtype["VCI_PCI9820"]=VCI_PCI9820;
	m_mapDevtype["VCI_PCI5110"]=VCI_PCI5110;
	m_mapDevtype["VCI_CANLITE"]=VCI_CANLITE;
	m_mapDevtype["VCI_ISA9620"]=VCI_ISA9620;
	m_mapDevtype["VCI_ISA5420"]=VCI_ISA5420;
	m_mapDevtype["VCI_PC104CAN"]=VCI_PC104CAN;
	m_mapDevtype["VCI_DNP9810"]=VCI_DNP9810;
	m_mapDevtype["VCI_PCI9840"]=VCI_PCI9840;
	m_mapDevtype["VCI_PC104CAN2"]=VCI_PC104CAN2;
	m_mapDevtype["VCI_PCI9820I"]=VCI_PCI9820I;
	m_mapDevtype["VCI_PEC9920"]=VCI_PEC9920;

}

void CTestDlg::DoDataExchange(CDataExchange* pDX)
{
	CDialog::DoDataExchange(pDX);
	//{{AFX_DATA_MAP(CTestDlg)
	DDX_Control(pDX, IDC_COMBO_devtype, m_ComboDevtype);
	DDX_Control(pDX, IDC_COMBO_BAUD1, m_ComboBaud);
	DDX_Control(pDX, IDC_COMBO_MODE, m_ComboMode);
	DDX_Control(pDX, IDC_COMBO_FILTERTYPE, m_ComboFilterType);
	DDX_Control(pDX, IDC_COMBO_CANIND, m_ComboCANInd);
	DDX_Control(pDX, IDC_COMBO_INDEX, m_ComboIndex);
	DDX_Control(pDX, IDC_LIST_INFO, m_ListInfo);
	DDX_Control(pDX, IDC_COMBO_SENDTYPE, m_ComboSendType);
	DDX_Control(pDX, IDC_COMBO_SENDFRAMETYPE, m_ComboSendFrmType);
	DDX_Control(pDX, IDC_COMBO_SENDFRAMEFORMAT, m_ComboSendFrmFmt);
	DDX_Text(pDX, IDC_EDIT_SENDDATA, m_EditSendData);
	DDX_Text(pDX, IDC_EDIT_SENDFRAMEID, m_EditSendFrmID);
	DDX_Text(pDX, IDC_EDIT_CODE, m_EditCode);
	DDX_Text(pDX, IDC_EDIT_MASK, m_EditMask);
	DDX_Text(pDX, IDC_EDIT_TIMING0, m_EditTiming0);
	DDX_Text(pDX, IDC_EDIT_TIMING1, m_EditTiming1);
	//}}AFX_DATA_MAP
}

BEGIN_MESSAGE_MAP(CTestDlg, CDialog)
	//{{AFX_MSG_MAP(CTestDlg)
	ON_WM_SYSCOMMAND()
	ON_WM_PAINT()
	ON_WM_QUERYDRAGICON()
	ON_BN_CLICKED(IDC_BUTTON_CONNECT, OnButtonConnect)
	ON_BN_CLICKED(IDC_BUTTON_STARTCAN, OnButtonStartcan)
	ON_BN_CLICKED(IDC_BUTTON_RESETCAN, OnButtonResetcan)
	ON_BN_CLICKED(IDC_BUTTON_SEND, OnButtonSend)
	ON_COMMAND(ID_MENU_REFRESH, OnMenuRefresh)
	ON_BN_CLICKED(IDC_BUTTON_recvsend, OnBUTTONrecvsend)
	ON_CBN_SELCHANGE(IDC_COMBO_BAUD1, OnSelchangeComboBaud1)
	ON_BN_CLICKED(IDC_BUTTON_clear, OnBUTTONclear)
	ON_BN_CLICKED(IDC_BUTTON_clearcnt, OnBUTTONclearcnt)
	ON_WM_TIMER()
	//}}AFX_MSG_MAP
END_MESSAGE_MAP()

/////////////////////////////////////////////////////////////////////////////
// CTestDlg message handlers

BOOL CTestDlg::OnInitDialog()
{
	CDialog::OnInitDialog();

	// Add "About..." menu item to system menu.

	// IDM_ABOUTBOX must be in the system command range.
	ASSERT((IDM_ABOUTBOX & 0xFFF0) == IDM_ABOUTBOX);
	ASSERT(IDM_ABOUTBOX < 0xF000);

	CMenu* pSysMenu = GetSystemMenu(FALSE);
	if (pSysMenu != NULL)
	{
		CString strAboutMenu;
		strAboutMenu.LoadString(IDS_ABOUTBOX);
		if (!strAboutMenu.IsEmpty())
		{
			pSysMenu->AppendMenu(MF_SEPARATOR);
			pSysMenu->AppendMenu(MF_STRING, IDM_ABOUTBOX, strAboutMenu);
		}
	}

	// Set the icon for this dialog.  The framework does this automatically
	//  when the application's main window is not a dialog
	SetIcon(m_hIcon, TRUE);			// Set big icon
	SetIcon(m_hIcon, FALSE);		// Set small icon

	// TODO: Add extra initialization here
	m_ComboSendType.SetCurSel(0);
	m_ComboSendFrmType.SetCurSel(0);
	m_ComboSendFrmFmt.SetCurSel(0);
	
	m_EditSendFrmID="00000080";
	m_EditSendData="01 02 03 04 05 06 07 08 ";
	
	CString str;
	
	for(int i=0;i<8;i++)
	{
		str.Format("%d",i);
		m_ComboIndex.AddString(str);
	}
	for(i=0;i<4;i++)
	{
		str.Format("%d",i);
		m_ComboCANInd.AddString(str);
	}
	//////////////////////////////////////////////////////////////////////////
	map<CString,int>::iterator itr=m_mapDevtype.begin();
	while(itr!=m_mapDevtype.end())
	{
		m_ComboDevtype.AddString(itr->first);
		//////////////////////////////////////////////////////////////////////////
		itr++;
	}
	m_ComboDevtype.SetCurSel(0);
	
	m_EditCode="00000000";
	m_EditMask="ffffffff";
	m_EditTiming0="00";
	m_EditTiming1="14";
	m_ComboIndex.SetCurSel(0);
	m_ComboCANInd.SetCurSel(0);
	m_ComboFilterType.SetCurSel(0);
	m_ComboMode.SetCurSel(0);

	m_ComboBaud.SetCurSel(0);
	
	UpdateData(false);
	InitializeCriticalSection(&m_Section);
	
	return TRUE;  // return TRUE  unless you set the focus to a control
}

void CTestDlg::OnSysCommand(UINT nID, LPARAM lParam)
{
	if ((nID & 0xFFF0) == IDM_ABOUTBOX)
	{
		CAboutDlg dlgAbout;
		dlgAbout.DoModal();
	}
	else
	{
		CDialog::OnSysCommand(nID, lParam);
	}
}

// If you add a minimize button to your dialog, you will need the code below
//  to draw the icon.  For MFC applications using the document/view model,
//  this is automatically done for you by the framework.

void CTestDlg::OnPaint() 
{
	if (IsIconic())
	{
		CPaintDC dc(this); // device context for painting

		SendMessage(WM_ICONERASEBKGND, (WPARAM) dc.GetSafeHdc(), 0);

		// Center icon in client rectangle
		int cxIcon = GetSystemMetrics(SM_CXICON);
		int cyIcon = GetSystemMetrics(SM_CYICON);
		CRect rect;
		GetClientRect(&rect);
		int x = (rect.Width() - cxIcon + 1) / 2;
		int y = (rect.Height() - cyIcon + 1) / 2;

		// Draw the icon
		dc.DrawIcon(x, y, m_hIcon);
	}
	else
	{
		CDialog::OnPaint();
	}
}

// The system calls this to obtain the cursor to display while the user drags
//  the minimized window.
HCURSOR CTestDlg::OnQueryDragIcon()
{
	return (HCURSOR) m_hIcon;
}

void CTestDlg::OnCancel() 
{
	// TODO: Add extra cleanup here
	int connect=m_connect;
	m_connect=0;
	if(connect)
	{
		Sleep(500);		
		VCI_CloseDevice(m_devtype,m_devind);
	}
	DeleteCriticalSection(&m_Section);
	CDialog::OnCancel();
}

void CTestDlg::OnOK() 
{
	// TODO: Add extra validation here
	int connect=m_connect;
	m_connect=0;
	Sleep(100);
	if(connect)
		VCI_CloseDevice(m_devtype,m_devind);
	
	DeleteCriticalSection(&m_Section);
	CDialog::OnOK();
}
void CTestDlg::OnButtonStartcan() 
{
	// TODO: Add your control notification handler code here
	if(m_connect==0)
		return;
	if(VCI_StartCAN(m_devtype,m_devind,m_cannum)==1)
	{
		ShowInfo("启动成功",0);	
	}
	else
	{
		CString str;
		str="启动失败";
		ShowInfo(str,2);
	}
	
}

// const DWORD GCanBrTab[10] = {
// 	0x060003, 0x060004, 0x060007,
// 		0x1C0008, 0x1C0011, 0x160023,
// 		0x1C002C, 0x1600B3, 0x1C00E0,
// 		0x1C01C1
// };
const CString g_tim0[10]=
{
	"00",		//1000Kbps
	"00",		// 800Kbps
	"00",		// 500Kbps
	"01",		// 250Kbps
	"03",		// 125Kbps
	"04",		// 100Kbps
	"09",		// 50Kbps
	"18",		// 20Kbps
	"31",		// 10Kbps
	"BF"		// 5Kbps	
};
const CString g_tim1[10]=
{
	"14",		//1000Kbps
	"16",		// 800Kbps
	"1C",		// 500Kbps
	"1C",		// 250Kbps
	"1C",		// 125Kbps
	"1C",		// 100Kbps
	"1C",		// 50Kbps
	"1C",		// 20Kbps
	"1C",		// 10Kbps
	"FF"		// 5Kbps	
};
void CTestDlg::OnButtonConnect() 
{
	// TODO: Add your control notification handler code here
	if(m_connect==1)
	{
		m_connect=0;
		Sleep(500);
		GetDlgItem(IDC_BUTTON_CONNECT)->SetWindowText("连接");
		VCI_CloseDevice(m_devtype,m_devind);

		KillTimer(ID_TIMER_SHOWCNT);
		return;
	}

	VCI_INIT_CONFIG init_config;
	int index,filtertype,mode,cannum;
	CString strcode,strmask,strtiming0,strtiming1,strtmp;
	char szcode[20],szmask[20],sztiming0[20],sztiming1[20];
	unsigned char sztmp[4];
	DWORD code,mask,timing0,timing1;
	
	UpdateData(true);
	index=m_ComboIndex.GetCurSel();
	filtertype=m_ComboFilterType.GetCurSel();
	mode=m_ComboMode.GetCurSel();
	cannum=m_ComboCANInd.GetCurSel();
	strcode=m_EditCode;
	strmask=m_EditMask;

	m_ComboDevtype.GetWindowText(strtmp);
	m_devtype = m_mapDevtype[strtmp];

//	INT baudindex=m_ComboBaud.GetCurSel();
// 	strtiming0=g_tim0[baudindex];
// 	strtiming1=g_tim1[baudindex];
	strtiming0=m_EditTiming0;
	strtiming1=m_EditTiming1;
	UpdateData(false);
	
	strtmp=strcode;
	strcode.Format("%08s",strtmp);
	strtmp=strmask;
	strmask.Format("%08s",strtmp);
	strtmp=strtiming0;
	strtiming0.Format("%02s",strtmp);
	strtmp=strtiming1;
	strtiming1.Format("%02s",strtmp);
	
	strcpy(szcode,(LPCTSTR)strcode);
	strcpy(szmask,(LPCTSTR)strmask);
	strcpy(sztiming0,(LPCTSTR)strtiming0);
	strcpy(sztiming1,(LPCTSTR)strtiming1);
	
	if(strtodata((unsigned char*)szcode,sztmp,4,0)!=0)
	{
		MessageBox("验收码数据格式不对!","警告",MB_OK|MB_ICONQUESTION);
		return;
	}
	code=(((DWORD)sztmp[0])<<24)+(((DWORD)sztmp[1])<<16)+(((DWORD)sztmp[2])<<8)+
		((DWORD)sztmp[3]);
	
	if(strtodata((unsigned char*)szmask,sztmp,4,0)!=0)
	{
		MessageBox("屏蔽码数据格式不对!","警告",MB_OK|MB_ICONQUESTION);
		return;
	}
	mask=(((DWORD)sztmp[0])<<24)+(((DWORD)sztmp[1])<<16)+(((DWORD)sztmp[2])<<8)+
		((DWORD)sztmp[3]);
	
	if(strtodata((unsigned char*)sztiming0,sztmp,1,0)!=0)
	{
		MessageBox("定时器0数据格式不对!","警告",MB_OK|MB_ICONQUESTION);
		return;
	}
	timing0=((DWORD)sztmp[0]);
	
	if(strtodata((unsigned char*)sztiming1,sztmp,1,0)!=0)
	{
		MessageBox("定时器1数据格式不对!","警告",MB_OK|MB_ICONQUESTION);
		return;
	}
	timing1=((DWORD)sztmp[0]);
	
	init_config.AccCode=code;
	init_config.AccMask=mask;
	init_config.Filter=filtertype;
	init_config.Mode=mode;
	init_config.Timing0=(UCHAR)timing0;
	init_config.Timing1=(UCHAR)timing1;
	
	if(VCI_OpenDevice(m_devtype,index,0)!=STATUS_OK)
	{
		MessageBox("打开设备失败!","警告",MB_OK|MB_ICONQUESTION);
		return;
	}
	if(VCI_InitCAN(m_devtype,index,cannum,&init_config)!=STATUS_OK)
	{
		MessageBox("初始化CAN失败!","警告",MB_OK|MB_ICONQUESTION);
		VCI_CloseDevice(m_devtype,index);
		return;
	}
	m_connect=1;
	m_devind=index;
	m_cannum=cannum;
	GetDlgItem(IDC_BUTTON_CONNECT)->SetWindowText("断开");

	m_recvcount=0;
	m_sendcnt=0;

	SetTimer(ID_TIMER_SHOWCNT,ID_TIMER_SHOWCNT_TM,NULL);
	AfxBeginThread(ReceiveThread,this);
}

void CTestDlg::OnButtonResetcan() 
{
	// TODO: Add your control notification handler code here
	if(m_connect==0)
		return;
	if(VCI_ResetCAN(m_devtype,m_devind,m_cannum)==1)
	{
		//GetDlgItem(IDC_BUTTON_STARTCAN)->EnableWindow(true);
		ShowInfo("复位成功",0);		
	}
	else
	{
		CString str;
		str="复位失败";
		ShowInfo(str,2);
	}
	
}

void CTestDlg::OnButtonSend() 
{
	// TODO: Add your control notification handler code here
	if(m_connect==0)
		return;
	VCI_CAN_OBJ frameinfo;
	char szFrameID[9];
	unsigned char FrameID[4]={0,0,0,0};
	memset(szFrameID,'0',9);
	unsigned char Data[8];
	char szData[25];
	BYTE datalen=0;
	
	UpdateData(true);
	if(m_EditSendFrmID.GetLength()==0||
		(m_EditSendData.GetLength()==0&&m_ComboSendFrmType.GetCurSel()==0))
	{
		ShowInfo("请输入数据",1);
		return;
	}
	
	if(m_EditSendFrmID.GetLength()>8)
	{
		ShowInfo("ID值超过范围",1);
		return;
	}
	if(m_EditSendData.GetLength()>24)
	{
		ShowInfo("数据长度超过范围,最大为8个字节",1);
		return;
	}
	if(m_ComboSendFrmType.GetCurSel()==0)
	{
		if(m_EditSendData.GetLength()%3==1)
		{
			ShowInfo("数据格式不对,请重新输入",1);
			return;		
		}		
	}
	memcpy(&szFrameID[8-m_EditSendFrmID.GetLength()],(LPCTSTR)m_EditSendFrmID,m_EditSendFrmID.GetLength());
	strtodata((unsigned char*)szFrameID,FrameID,4,0);

	datalen=(m_EditSendData.GetLength()+1)/3;
	strcpy(szData,(LPCTSTR)m_EditSendData);
	strtodata((unsigned char*)szData,Data,datalen,1);


	UpdateData(false);
	
	frameinfo.DataLen=datalen;
	memcpy(&frameinfo.Data,Data,datalen);

	frameinfo.RemoteFlag=m_ComboSendFrmFmt.GetCurSel();
	frameinfo.ExternFlag=m_ComboSendFrmType.GetCurSel();
	if(frameinfo.ExternFlag==1)
	{
		frameinfo.ID=((DWORD)FrameID[0]<<24)+((DWORD)FrameID[1]<<16)+((DWORD)FrameID[2]<<8)+
			((DWORD)FrameID[3]);
	}
	else
	{
		frameinfo.ID=((DWORD)FrameID[2]<<8)+((DWORD)FrameID[3]);		
	}
	frameinfo.SendType=m_ComboSendType.GetCurSel();

	if(VCI_Transmit(m_devtype,m_devind,m_cannum,&frameinfo,1)==1)
	{
		m_sendcnt += 1;
		ShowInfo("写入成功",0);		
	}
	else
	{
		ShowInfo("写入失败",2);		
	}
	
}

void CTestDlg::ShowInfo(CString str, int code)
{
	m_ListInfo.InsertString(m_ListInfo.GetCount(),str);
	m_ListInfo.SetCurSel(m_ListInfo.GetCount()-1);
}

//-----------------------------------------------------
//参数：
//str：要转换的字符串
//data：储存转换过来的数据串
//len:数据长度
//函数功能：字符串转换为数据串
//-----------------------------------------------------
int CTestDlg::strtodata(unsigned char *str, unsigned char *data,int len,int flag)
{
	unsigned char cTmp=0;
	int i=0;
	for(int j=0;j<len;j++)
	{
		if(chartoint(str[i++],&cTmp))
			return 1;
		data[j]=cTmp;
		if(chartoint(str[i++],&cTmp))
			return 1;
		data[j]=(data[j]<<4)+cTmp;
		if(flag==1)
			i++;
	}
	return 0;
}

//-----------------------------------------------------
//参数：
//chr：要转换的字符
//cint：储存转换过来的数据
//函数功能：字符转换为数据
//-----------------------------------------------------
int CTestDlg::chartoint(unsigned char chr, unsigned char *cint)
{
	unsigned char cTmp;
	cTmp=chr-48;
	if(cTmp>=0&&cTmp<=9)
	{
		*cint=cTmp;
		return 0;
	}
	cTmp=chr-65;
	if(cTmp>=0&&cTmp<=5)
	{
		*cint=(cTmp+10);
		return 0;
	}
	cTmp=chr-97;
	if(cTmp>=0&&cTmp<=5)
	{
		*cint=(cTmp+10);
		return 0;
	}
	return 1;
}
static UINT s_id=1;
UINT CTestDlg::ReceiveThread(void *param)
{
	CTestDlg *dlg=(CTestDlg*)param;
	CListBox *box=(CListBox *)dlg->GetDlgItem(IDC_LIST_INFO);
	VCI_CAN_OBJ frameinfo[50];
	VCI_ERR_INFO errinfo;
	int len=1;
	int i=0;
	CString str,tmpstr;
	while(1)
	{
		Sleep(1);
		if(dlg->m_connect==0)
			break;
		len=VCI_Receive(dlg->m_devtype,dlg->m_devind,dlg->m_cannum,frameinfo,50,200);
		if(len<=0)
		{
			//注意：如果没有读到数据则必须调用此函数来读取出当前的错误码，
			//千万不能省略这一步（即使你可能不想知道错误码是什么）
			VCI_ReadErrInfo(dlg->m_devtype,dlg->m_devind,dlg->m_cannum,&errinfo);
		}                                                                              
		else
		{
#if 1
			dlg->m_recvcount += len;
			str.Format("         本次接收 %d 帧  总接收 %d 帧",len,dlg->m_recvcount);
			box->InsertString(box->GetCount(),str);
			for(i=0;i<len;i++)
			{
				str="接收到CAN帧:  ";
				if(frameinfo[i].TimeFlag==0)
					tmpstr="时间标识:无  ";
				else
					tmpstr.Format("时间标识:%08x ",frameinfo[i].TimeStamp);
				str+=tmpstr;
				tmpstr.Format("帧ID:%08x ",frameinfo[i].ID);
				str+=tmpstr;
				str+="帧格式:";
				if(frameinfo[i].RemoteFlag==0)
					tmpstr="数据帧 ";
				else
					tmpstr="远程帧 ";
				str+=tmpstr;
				str+="帧类型:";
				if(frameinfo[i].ExternFlag==0)
					tmpstr="标准帧 ";
				else
					tmpstr="扩展帧 ";
				str+=tmpstr;
 				box->InsertString(box->GetCount(),str);
				if(frameinfo[i].RemoteFlag==0)
				{
					str="数据:";
					if(frameinfo[i].DataLen>8)
						frameinfo[i].DataLen=8;
					for(int j=0;j<frameinfo[i].DataLen;j++)
					{
						tmpstr.Format("%02x ",frameinfo[i].Data[j]);
						str+=tmpstr;
					}
					//EnterCriticalSection(&(dlg->m_Section));
					//LeaveCriticalSection(&(dlg->m_Section));
 					box->InsertString(box->GetCount(),str);
				}
// 				if (box->GetCount()>50)
// 				{
// 					box->ResetContent();
// 				}
			}
			if (dlg->m_btest)
			{
			//	frameinfo[0].Data[0]=0xff;
			//	frameinfo[0].Data[1]=0xff;
				ULONG ret=VCI_Transmit(dlg->m_devtype,dlg->m_devind,dlg->m_cannum,&frameinfo[0],len);
				dlg->m_testcount += ret;
				CTime tm=CTime::GetCurrentTime();
				if ((int)ret!=len)
				{
					str.Format("本次回复 %d 帧  实际回复 %d 帧 总回复 %d 帧 ----------回复不正常",len,ret,dlg->m_testcount);

				}else
				{
					str.Format("本次回复 %d 帧  实际回复 %d 帧 总回复 %d 帧",len,ret,dlg->m_testcount);
				}
				box->InsertString(box->GetCount(),str);
				str=tm.Format("%Y_%m_%d_%H_%M_%S") +" --- " + str;
				dlg->m_f.Write(str,str.GetLength());
			}
			box->SetCurSel(box->GetCount()-1);
#endif
#if 0
		//	static UINT s_id=1;
			for (int i=0;i<len;i++)
			{
				str.Format("s_id=%d  frameinfo[i].ID=%d\n",s_id,frameinfo[i].ID);
				if (frameinfo[i].ID != s_id)
				{
					str += "err err err---------------------------------err err\r\n";
					
				}
				box->InsertString(box->GetCount(),str);
				
				TRACE(str);
				s_id++;
				if (s_id>66)
				{
					s_id=1;
					str.Format("  66  --------------------------------------\r\n");
					box->InsertString(box->GetCount(),str);
				}
			}
#endif

		}
	}
	return 0;
}

void CTestDlg::OnMenuRefresh() 
{
	// TODO: Add your command handler code here
}
void CTestDlg::OnBUTTONrecvsend() 
{
	// TODO: Add your control notification handler code here
	CString str;
	CTime tm=CTime::GetCurrentTime();
	if (!m_btest)
	{
		m_btest=TRUE;
		GetDlgItem(IDC_BUTTON_recvsend)->SetWindowText("关闭测试");

		str="test"+tm.Format("%Y_%m_%d_%H_%M_%S")+".txt";
		m_f.Open(str,CFile::modeCreate|CFile::modeWrite);
		str="测试开始-----\r\n";
		m_f.Write(str,str.GetLength());
		m_testcount=0;
	}else
	{
		m_btest=FALSE;
		GetDlgItem(IDC_BUTTON_recvsend)->SetWindowText("启动接收发送测试");

		str="测试结束--"+ tm.Format("%Y_%m_%d_%H_%M_%S") + "----\r\n";
		m_f.Write(str,str.GetLength());
		m_f.Close();
	}
}

void CTestDlg::OnSelchangeComboBaud1() 
{
	// TODO: Add your control notification handler code here
	int index = m_ComboBaud.GetCurSel();

	if (10==index)//自定义波特率
	{
		GetDlgItem(IDC_EDIT_TIMING0)->EnableWindow(TRUE);
		GetDlgItem(IDC_EDIT_TIMING1)->EnableWindow(TRUE);
	}else
	{
		GetDlgItem(IDC_EDIT_TIMING0)->EnableWindow(FALSE);
		GetDlgItem(IDC_EDIT_TIMING1)->EnableWindow(FALSE);
		GetDlgItem(IDC_EDIT_TIMING0)->SetWindowText(g_tim0[index]);
		GetDlgItem(IDC_EDIT_TIMING1)->SetWindowText(g_tim1[index]);
	}	
}

void CTestDlg::OnBUTTONclear() 
{
	// TODO: Add your control notification handler code here
	((CListBox *)GetDlgItem(IDC_LIST_INFO))->ResetContent();
	s_id=1;
}

void CTestDlg::OnBUTTONclearcnt() 
{
	// TODO: Add your control notification handler code here
	m_sendcnt=0;
	m_recvcount=0;
	ShowCnt();
}

void CTestDlg::OnTimer(UINT nIDEvent) 
{
	// TODO: Add your message handler code here and/or call default
	if (ID_TIMER_SHOWCNT==nIDEvent)
	{
		ShowCnt();
	}
	
	CDialog::OnTimer(nIDEvent);
}
