luyou-2023/VCU-DEV-DOCS/VCU整套开发源码+PCB原理图+说明书/VCU用户资料/软件部分/赠送资料/USBCAN接口卡/API/API Samples/vc6/test/test.h

// test.h : main header file for the TEST application
//

#if !defined(AFX_TEST_H__988D6DD6_C056_4921_AE9C_CF2997D6D8A2__INCLUDED_)
#define AFX_TEST_H__988D6DD6_C056_4921_AE9C_CF2997D6D8A2__INCLUDED_

#if _MSC_VER > 1000
#pragma once
#endif // _MSC_VER > 1000

#ifndef __AFXWIN_H__
	#error include 'stdafx.h' before including this file for PCH
#endif

#include "resource.h"		// main symbols

/////////////////////////////////////////////////////////////////////////////
// CTestApp:
// See test.cpp for the implementation of this class
//

class CTestApp : public CWinApp
{
public:
	CTestApp();

// Overrides
	// ClassWizard generated virtual function overrides
	//{{AFX_VIRTUAL(CTestApp)
	public:
	virtual BOOL InitInstance();
	//}}AFX_VIRTUAL

// Implementation

	//{{AFX_MSG(CTestApp)
		// NOTE - the ClassWizard will add and remove member functions here.
		//    DO NOT EDIT what you see in these blocks of generated code !
	//}}AFX_MSG
	DECLARE_MESSAGE_MAP()
};


/////////////////////////////////////////////////////////////////////////////

//{{AFX_INSERT_LOCATION}}
// Microsoft Visual C++ will insert additional declarations immediately before the previous line.

#endif // !defined(AFX_TEST_H__988D6DD6_C056_4921_AE9C_CF2997D6D8A2__INCLUDED_)
