luyou-2023/VCU-DEV-DOCS/VCU整套开发源码+PCB原理图+说明书/VCU用户资料/软件部分/赠送资料/USBCAN接口卡/API/API Samples/vc6/test/StdAfx.h

// stdafx.h : include file for standard system include files,
//  or project specific include files that are used frequently, but
//      are changed infrequently
//

#if !defined(AFX_STDAFX_H__904820D8_CF40_4CF4_9C81_23436C166DDB__INCLUDED_)
#define AFX_STDAFX_H__904820D8_CF40_4CF4_9C81_23436C166DDB__INCLUDED_

#if _MSC_VER > 1000
#pragma once
#endif // _MSC_VER > 1000

#define VC_EXTRALEAN		// Exclude rarely-used stuff from Windows headers

#include <afxwin.h>         // MFC core and standard components
#include <afxext.h>         // MFC extensions
#include <afxdisp.h>        // MFC Automation classes
#include <afxdtctl.h>		// MFC support for Internet Explorer 4 Common Controls
#ifndef _AFX_NO_AFXCMN_SUPPORT
#include <afxcmn.h>			// MFC support for Windows Common Controls
#endif // _AFX_NO_AFXCMN_SUPPORT


//{{AFX_INSERT_LOCATION}}
// Microsoft Visual C++ will insert additional declarations immediately before the previous line.

#endif // !defined(AFX_STDAFX_H__904820D8_CF40_4CF4_9C81_23436C166DDB__INCLUDED_)
