luyou-2023/VCU-DEV-DOCS/VCU整套开发源码+PCB原理图+说明书/VCU用户资料/软件部分/赠送资料/USBCAN接口卡/API/API Samples/vc6/test/testDlg.h

// testDlg.h : header file
//

#if !defined(AFX_TESTDLG_H__0B453A60_AE2F_4119_AF51_CC52D47F30DF__INCLUDED_)
#define AFX_TESTDLG_H__0B453A60_AE2F_4119_AF51_CC52D47F30DF__INCLUDED_

#if _MSC_VER > 1000
#pragma once
#endif // _MSC_VER > 1000

/////////////////////////////////////////////////////////////////////////////
// CTestDlg dialog
#include "TestListBox.h"

#pragma warning(disable:4786)
#include <map>
using namespace std;

class CTestDlg : public CDialog
{
	// Construction
public:
	int m_cannum;
	int m_devtype;
	DWORD m_devind;
	static UINT ReceiveThread(void *param);
	void ShowInfo(CString str,int code);
	int m_connect;
	CTestDlg(CWnd* pParent = NULL);	// standard constructor
	int strtodata(unsigned char *str, unsigned char *data,int len,int flag);
	int chartoint(unsigned char chr, unsigned char *cint);
	// Dialog Data
	//{{AFX_DATA(CTestDlg)
	enum { IDD = IDD_TEST_DIALOG };
	CComboBox	m_ComboDevtype;
	CComboBox	m_ComboBaud;
	CComboBox	m_ComboMode;
	CComboBox	m_ComboFilterType;
	CComboBox	m_ComboCANInd;
	CComboBox	m_ComboIndex;
	CTestListBox	m_ListInfo;
	CComboBox	m_ComboSendType;
	CComboBox	m_ComboSendFrmType;
	CComboBox	m_ComboSendFrmFmt;
	CString	m_EditSendData;
	CString	m_EditSendFrmID;
	CString	m_EditCode;
	CString	m_EditMask;
	CString	m_EditTiming0;
	CString	m_EditTiming1;
	//}}AFX_DATA
	BOOL m_btest;
	ULONG m_testcount;

	CFile m_f;

	////设备类型名称及型号
	map<CString,int> m_mapDevtype;
	//发送接收计数
	DWORD m_sendcnt;
	DWORD m_recvcount;
	void ShowCnt()
	{
		CString strtmp;
		strtmp.Format("%5d",m_sendcnt);
		GetDlgItem(IDC_STATIC_send)->SetWindowText(strtmp);
		strtmp.Format("%5d",m_recvcount);
		GetDlgItem(IDC_STATIC_recv)->SetWindowText(strtmp);
	}

	// ClassWizard generated virtual function overrides
	//{{AFX_VIRTUAL(CTestDlg)
protected:
	virtual void DoDataExchange(CDataExchange* pDX);	// DDX/DDV support
	//}}AFX_VIRTUAL
	
	// Implementation
protected:
	HICON m_hIcon;
	CRITICAL_SECTION m_Section;
	// Generated message map functions
	//{{AFX_MSG(CTestDlg)
	virtual BOOL OnInitDialog();
	afx_msg void OnSysCommand(UINT nID, LPARAM lParam);
	afx_msg void OnPaint();
	afx_msg HCURSOR OnQueryDragIcon();
	virtual void OnCancel();
	virtual void OnOK();
	afx_msg void OnButtonConnect();
	afx_msg void OnButtonStartcan();
	afx_msg void OnButtonResetcan();
	afx_msg void OnButtonSend();
	afx_msg void OnMenuRefresh();
	afx_msg void OnBUTTONrecvsend();
	afx_msg void OnSelchangeComboBaud1();
	afx_msg void OnBUTTONclear();
	afx_msg void OnBUTTONclearcnt();
	afx_msg void OnTimer(UINT nIDEvent);
	//}}AFX_MSG
	DECLARE_MESSAGE_MAP()
};

//{{AFX_INSERT_LOCATION}}
// Microsoft Visual C++ will insert additional declarations immediately before the previous line.

#endif // !defined(AFX_TESTDLG_H__0B453A60_AE2F_4119_AF51_CC52D47F30DF__INCLUDED_)
